robert-saramet/alset/docs/graphics/text/text.png

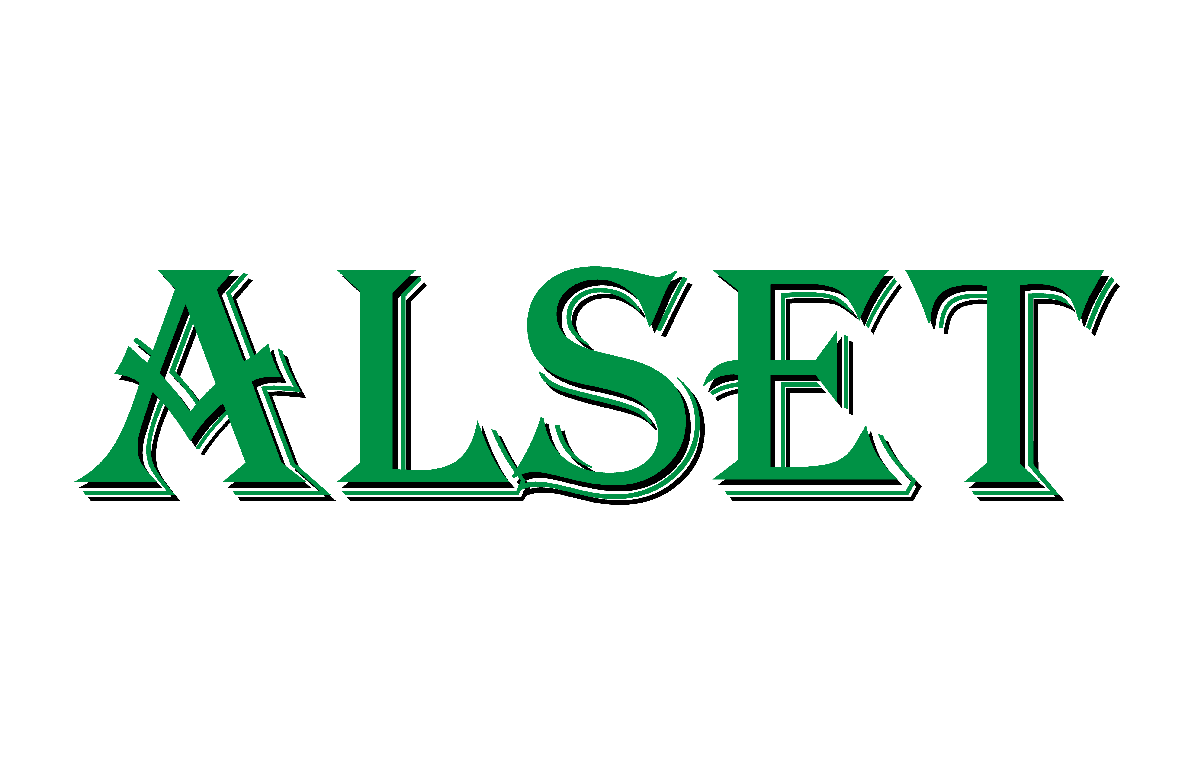
docs/graphics/text/text.png
