robert-saramet/alset/(list of files, drawings)

Other design files:
docs/schematics/power.fzz
docs/schematics/schema.fzz
