robert-saramet/alset/arduino/esp32_thing/ps4_joystick.cpp

#include "SerialTransfer.h"
#include <PS4Controller.h>

SerialTransfer myTransfer;

struct Motors {
    int8_t relSpeed;
    uint8_t pos;
    bool turbo;
} motorStruct;

struct Sonars {
    uint8_t distF;
    uint8_t distFL;
    uint8_t distFR;
} sonarStruct;

char cmd[] = "move";
bool turbo = 0;

short distF;
short distFL;
short distFR;

long lastSend = millis();

void sendSpeed(int relSpeed = 0, int pos = 0, bool turbo = 0) {
    uint16_t sendSize = 0;
    motorStruct.relSpeed = relSpeed;
    motorStruct.pos = pos;
    motorStruct.turbo = turbo;
    sendSize = myTransfer.txObj(motorStruct, sendSize);
    sendSize = myTransfer.txObj(cmd, sendSize);
    myTransfer.sendData(sendSize);
}

void getSonar() {
    if(myTransfer.available()){
        uint16_t recSize = 0;
        recSize = myTransfer.rxObj(sonarStruct, recSize);
        recSize = myTransfer.rxObj(cmd, recSize);
        distF = sonarStruct.distF;
        distFL = sonarStruct.distFL;
        distFR = sonarStruct.distFR;
    }
}

void sendToJoystick() {
    short min;
    if (distF  <= distFL) {
        min = distF;
    }
    else {
        if (distFL <= distFR) {
            min = distFL;
        }
        else min = distFR;
    }

    short red = map(min, 0, 45, 255, 0);
    short green = 255 - red;

    PS4.setLed(red, green, 0);

    short rumbleL, rumbleR;
    if (distF <= distFL && distF <= distFR) {
        rumbleL = rumbleR = map(distF, 0, 45, 255, 0);
    }
    else {
        rumbleL = map(distFL, 0, 45, 255, 0);
        rumbleR = map(distFR, 0, 45, 255, 0);
    }
    
    PS4.setRumble(rumbleL, rumbleR);
    PS4.sendToController();
}

void setup()
{
  Serial.begin(115200);
  PS4.begin("00:de:ad:be:ef:00");
  Serial2.begin(115200);
  myTransfer.begin(Serial2);
}


void loop()
{
  int mapX, mapY;

  //turbo
  if (PS4.Triangle()) {
      turbo = 1;
  }
  else {
      turbo = 0;
  }
  // forward
  if (PS4.R2Value() > 10 && PS4.L2Value() < 10) {
    mapY = map(PS4.R2Value(), 0, 255, 0, 100);
  }
  // backward
  else if (PS4.L2Value() > 10 && PS4.R2Value() < 10) {
    mapY = map(PS4.L2Value(), 0, 255, 0, -100);
  }
  // brake
  else {
    mapY = 0;
  }

  mapX = map(PS4.LStickX(), -128, 127, 0, 180);


  sendSpeed(mapY, mapX, turbo);

  getSonar();

  if ((millis() - lastSend) > 30) {
      sendToJoystick();
      lastSend = millis();
  }
}
