robert-saramet/alset/(commit log)

2021-04-29 Switch to analog PD control
2021-05-04 Add fallback impact switch interrupt
2021-05-29 Tuned PD for smoother steering
2021-06-01 Update and rename arduino/Robot/Robot.cpp to arduino/library/Robot.cpp
2021-06-01 Update and rename arduino/Robot/Robot.h to arduino/library/Robot.h
2021-06-04 Clean useless code up & fix for new motor driver
2021-06-04 Fix for new motor driver
2021-06-09 Remove obsolete servo references
2021-06-25 Update main.cpp
    - Add failsafe
    - Fix reverse
    - Refactor
    [main.cpp]
2021-07-10 Update main.cpp
    - Change ultrasonic timeout
    - Add turbo mode
2021-07-11 Update ps4_joystick.cpp
    - Add vibration and led indicator for obstacle distance
    [ps4_joystick.cpp]
2021-07-11 Adjust sonar timeout
2021-07-12 Update avoid_obstacles_semi.cpp
    - Enable switching between manual and obstacle avoiding
    - Reverse direction when going backwards
    - Make steering more aggressive
    - Brake on controller disconnect
    [avoid_obstacles_semi.cpp]
2021-07-12 Update avoid_obstacles_semi.cpp
    Fix mode switching
    [avoid_obstacles_semi.cpp]
2021-07-12 Update avoid_obstacles_semi.cpp
    - Add struct for old values
    - Avoid excessive steering by comparing current distances with those from the OldData struct
    - Fix struct naming style
    - Add SonarStruct division operator
    [avoid_obstacles_semi.cpp]
2021-07-13 Update avoid_obstacles_semi.cpp
    - Expand sonar range
    - Edit obstacle avoidance algorithm
    [avoid_obstacles_semi.cpp]
2021-07-13 Update main.cpp
    - Expand sonar range to 60 cm
2021-07-13 Update avoid_obstacles_semi.cpp
    - Fixed sensor selector for RGB
    - Mapped rumble to full sonar range
    [avoid_obstacles_semi.cpp]
2021-07-23 Remove obsolete cmd payload, add encoder
2021-07-25 Update main.cpp
    - Add I2C to Serial forwarding from 328PB to ESP32
    - Make structs cross-platform
2021-07-25 Update main.cpp
    - Switch I2C to Master mode
    - Fix sendData() to actually send the data
    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
    [main.cpp]
2021-07-25 Update avoid_obstacles_semi.cpp
    Make structs cross-platform
    [avoid_obstacles_semi.cpp]
2021-07-26 Update avoid_obstacles_semi.cpp
    - Receive new mixedData struct
    - Enhance (???) pathplanning
    - Add fullAuto flag
    [avoid_obstacles_semi.cpp]
2021-07-29 Update avoid_obstacles_semi.cpp
    Add controller killswitch
    [avoid_obstacles_semi.cpp]
2022-01-14 Switch to BLE for better connection stability
    [phone_bt.cpp]
2022-01-24 Fix ESP-NOW bug and reduce latency
    [main.cpp]
2022-05-30 Handle missing GPS signal
    [main.cpp]
2022-05-30 Fix servo jerking in autopilot
    [phone_bt.cpp]
2022-06-01 Fix servo jerking for PS4 mode
    [main.cpp]
